yifancui123/ENGG2000/(commit log)

2026-08-16 Add project README for MQ Sentinel
    Describe the ENGG2000 SPINE project: autonomous IR beacon-tracking
    reaction-wheel satellite, IR sensing subsystem, hardware, repo structure,
    and sprint roadmap.
2026-11-02 Integrated fine and coarse sensing code with motor controls
2026-11-04 Add A0/A1 sensor test code and mount design PDFs
    - a1a2_test: non-blocking A0/A1 read with seen / not-seen decision.
    - gate_test: single-sensor TSSP strength test.
    - Sensor mount design PDFs for review.
    Moved from sensor-gate-test onto current main so the branch only
    carries this work.
2026-11-04 Remove gate_test sketch
    Single-sensor bench test, no longer needed in the repo.
